bieringnil/bioamp-simple/bioamp-simple.kicad_pcb

## KiCad design bioamp-simple.kicad_pcb (2024-01-02)

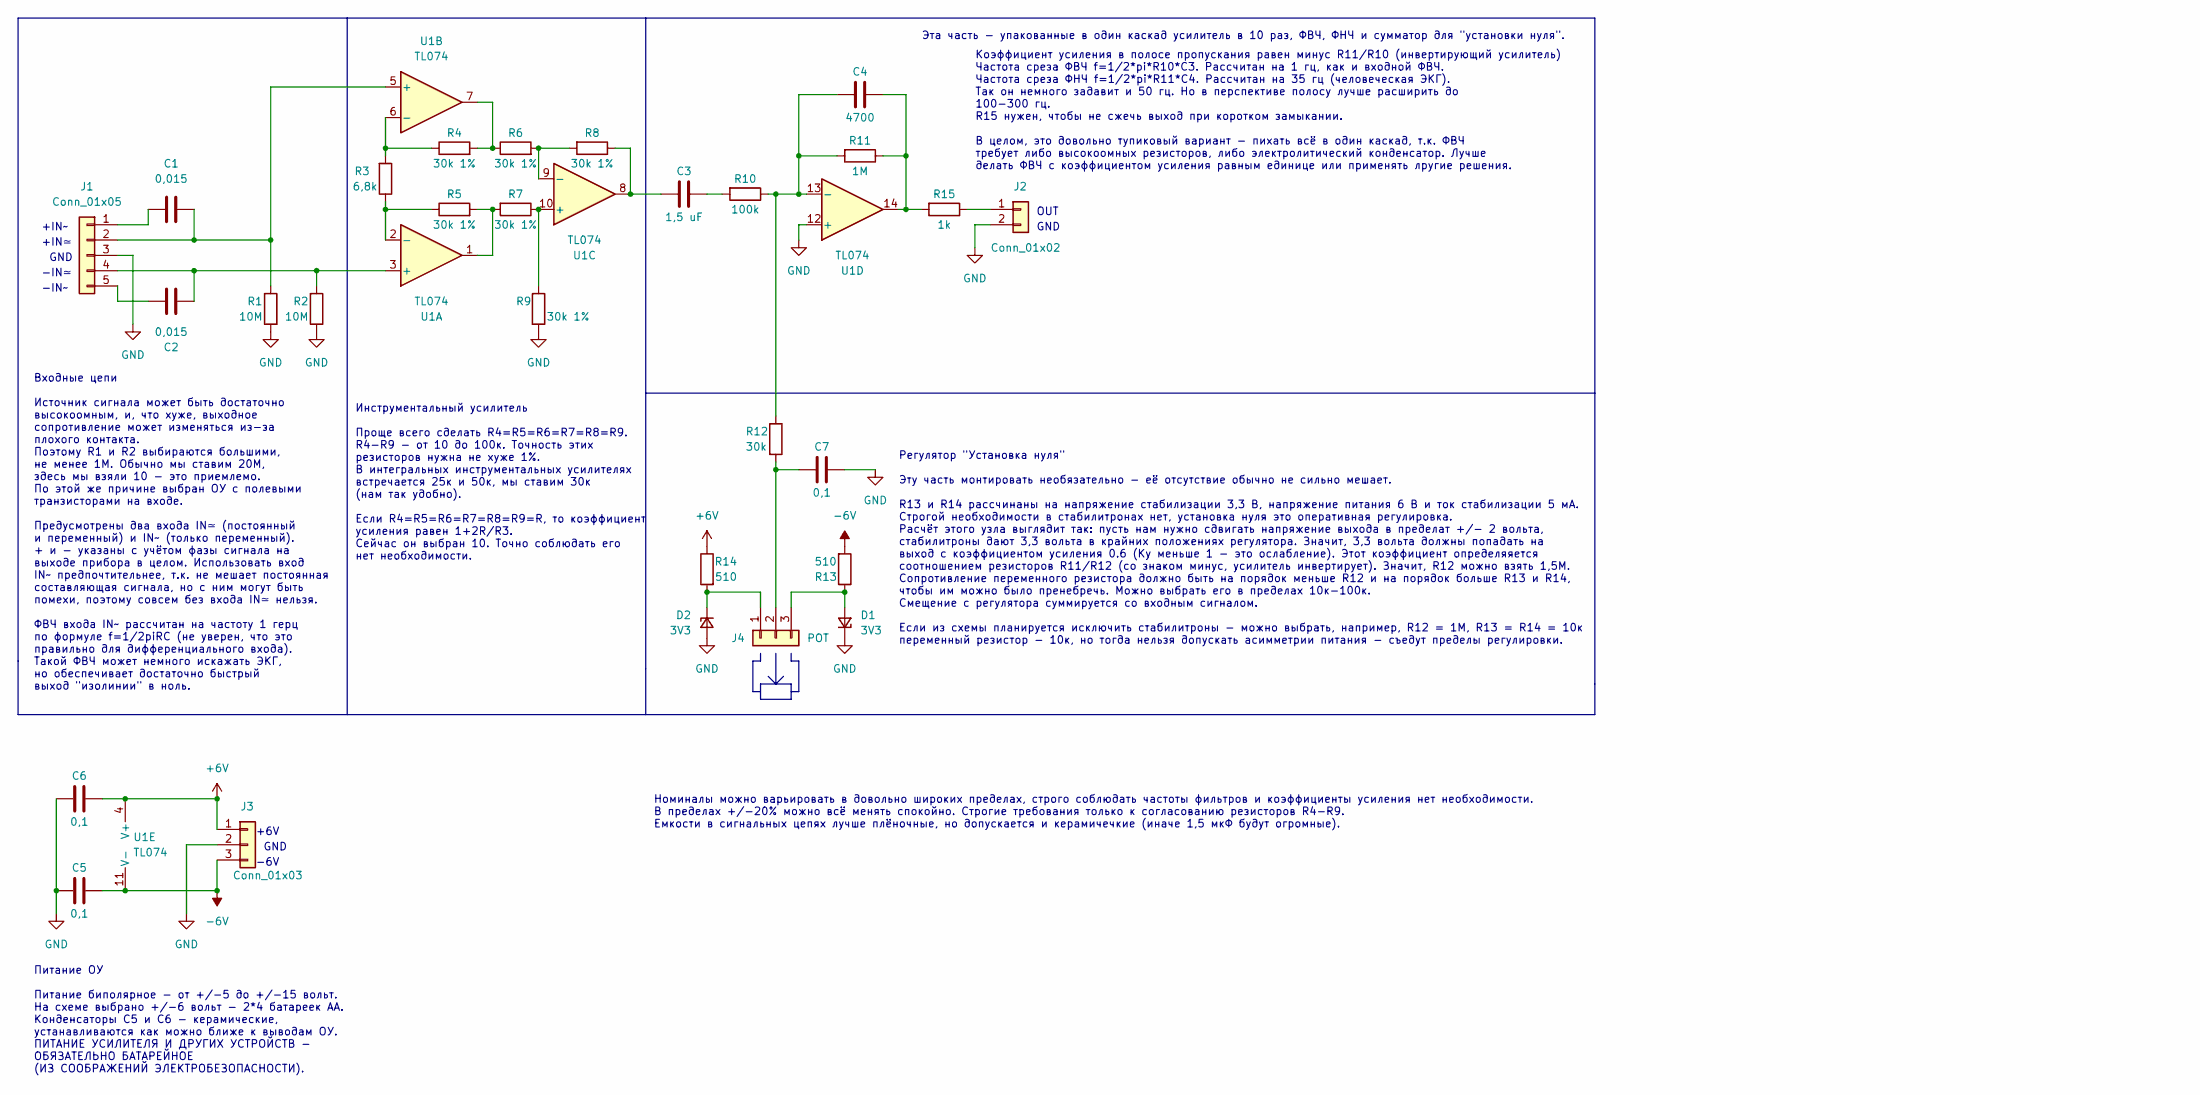
[picture p1: schematic bioamp-simple.kicad_sch]

Parts:
C1, C2: 0,015; C_Rect_L7.0mm_W4.5mm_P5.00mm
C3: 1,5 uF; C_Rect_L16.5mm_W5.0mm_P15.00mm_MKT
C4: 4700; C_Rect_L7.0mm_W4.5mm_P5.00mm
C5, C6, C7: 0,1; C_Rect_L7.0mm_W4.5mm_P5.00mm
D1, D2: 3V3; D_A-405_P10.16mm_Horizontal
J1: Conn_01x05; SolderWire-0.5sqmm_1x05_P4.6mm_D0.9mm_OD2.1mm
J2: Conn_01x02; SolderWire-0.5sqmm_1x02_P4.6mm_D0.9mm_OD2.1mm
J3: Conn_01x03; SolderWire-0.5sqmm_1x03_P4.6mm_D0.9mm_OD2.1mm
J4: POT; SolderWire-0.5sqmm_1x03_P4.6mm_D0.9mm_OD2.1mm
R1, R2: 10M; R_Axial_DIN0207_L6.3mm_D2.5mm_P15.24mm_Horizontal
R3: 6,8k; R_Axial_DIN0207_L6.3mm_D2.5mm_P10.16mm_Horizontal
R4, R5, R8: 30k 1%; R_Axial_DIN0207_L6.3mm_D2.5mm_P2.54mm_Vertical
R6, R7, R9: 30k 1%; R_Axial_DIN0207_L6.3mm_D2.5mm_P10.16mm_Horizontal
R10: 100k; R_Axial_DIN0207_L6.3mm_D2.5mm_P10.16mm_Horizontal
R11: 1M; R_Axial_DIN0207_L6.3mm_D2.5mm_P2.54mm_Vertical
R12: 30k; R_Axial_DIN0207_L6.3mm_D2.5mm_P10.16mm_Horizontal
R13, R14: 510; R_Axial_DIN0207_L6.3mm_D2.5mm_P10.16mm_Horizontal
R15: 1k; R_Axial_DIN0207_L6.3mm_D2.5mm_P10.16mm_Horizontal
U1: TL074; DIP-14_W7.62mm_LongPads

Connections:
+6V: C6.2, J3.1, R14.1, U1.4 (V+)
-6V: C5.2, J3.3, R13.2, U1.11 (V-)
GND: C5.1, C6.1, C7.2, D1.1 (K), D2.2 (A), J1.3, J2.2, J3.2, R1.2, R2.1, R9.2, U1.12 (+)
unnamed: C3.1, R8.1, U1.8
unnamed: C3.2, R10.2
unnamed: C4.2, R11.1, R15.2, U1.14
unnamed: D1.2 (A), J4.3, R13.1
unnamed: D2.1 (K), J4.1, R14.2
unnamed: C1.1, J1.1
unnamed: C1.2, J1.2, R1.1, U1.5 (+)
unnamed: C2.2, J1.4, R2.2, U1.3 (+)
unnamed: C2.1, J1.5
unnamed: J2.1, R15.1
unnamed: C7.1, J4.2, R12.2
unnamed: R4.2, R6.1, U1.7
unnamed: R5.2, R7.2, U1.1
unnamed: R3.1, R5.1, U1.2 (-)
unnamed: R3.2, R4.1, U1.6 (-)
unnamed: R7.1, R9.1, U1.10 (+)
unnamed: R6.2, R8.2, U1.9 (-)
unnamed: C4.1, R10.1, R11.2, R12.1, U1.13 (-)

Notes on the sheet:
+IN~
Входные цепи Источник сигнала может быть достаточно высокоомным, и, что хуже, выходное сопротивление может изменяться из-за плохого контакта. Поэтому R1 и R2 выбираются большими, не менее 1М. Обычно мы ставим 20М, здесь мы взяли 10 - это приемлемо. По этой же причине выбран ОУ с полевыми транзистор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
+6V
OUT
Питание ОУ Питание биполярное - от +/-5 до +/-15 вольт. На схеме выбрано +/-6 вольт - 2*4 батареек АА. Конденсаторы C5 и C6 - керамические, устанавливаются как можно ближе к выводам ОУ. ПИТАНИЕ УСИЛИТЕЛЯ И ДРУГИХ УСТРОЙСТВ - ОБЯЗАТЕЛЬНО БАТАРЕЙНОЕ (ИЗ СООБРАЖЕНИЙ ЭЛЕКТРОБЕЗОПАСНОСТИ).
-IN≃
Инструментальный усилитель Проще всего сделать R4=R5=R6=R7=R8=R9. R4-R9 - от 10 до 100к. Точность этих резисторов нужна не хуже 1%. В интегральных инструментальных усилителях встречается 25к и 50к, мы ставим 30к (нам так удобно). Если R4=R5=R6=R7=R8=R9=R, то коэффициент усиления равен 1+2R/R3. Сейч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
Эта часть - упакованные в один каскад усилитель в 10 раз, ФВЧ, ФНЧ и сумматор для "установки нуля".
GND
Регулятор "Установка нуля" Эту часть монтировать необязательно - её отсутствие обычно не сильно мешает. R13 и R14 рассчинаны на напряжение стабилизации 3,3 В, напряжение питания 6 В и ток стабилизации 5 мА. Строгой необходимости в стабилитронах нет, установка нуля это оперативная регулировка. Расчё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
-6V
Коэффициент усиления в полосе пропускания равен минус R11/R10 (инвертирующий усилитель) Частота среза ФВЧ f=1/2*pi*R10*C3. Рассчитан на 1 гц, как и входной ФВЧ. Частота среза ФНЧ f=1/2*pi*R11*C4. Рассчитан на 35 гц (человеческая ЭКГ). Так он немного задавит и 50 гц. Но в перспективе полосу лучше ра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
Номиналы можно варьировать в довольно широких пределах, строго соблюдать частоты фильтров и коэффициенты усиления нет необходимости. В пределах +/-20% можно всё менять спокойно. Строгие требования только к согласованию резисторов R4-R9. Емкости в сигнальных цепях лучше плёночные, но допускается и к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
+IN≃
-IN~

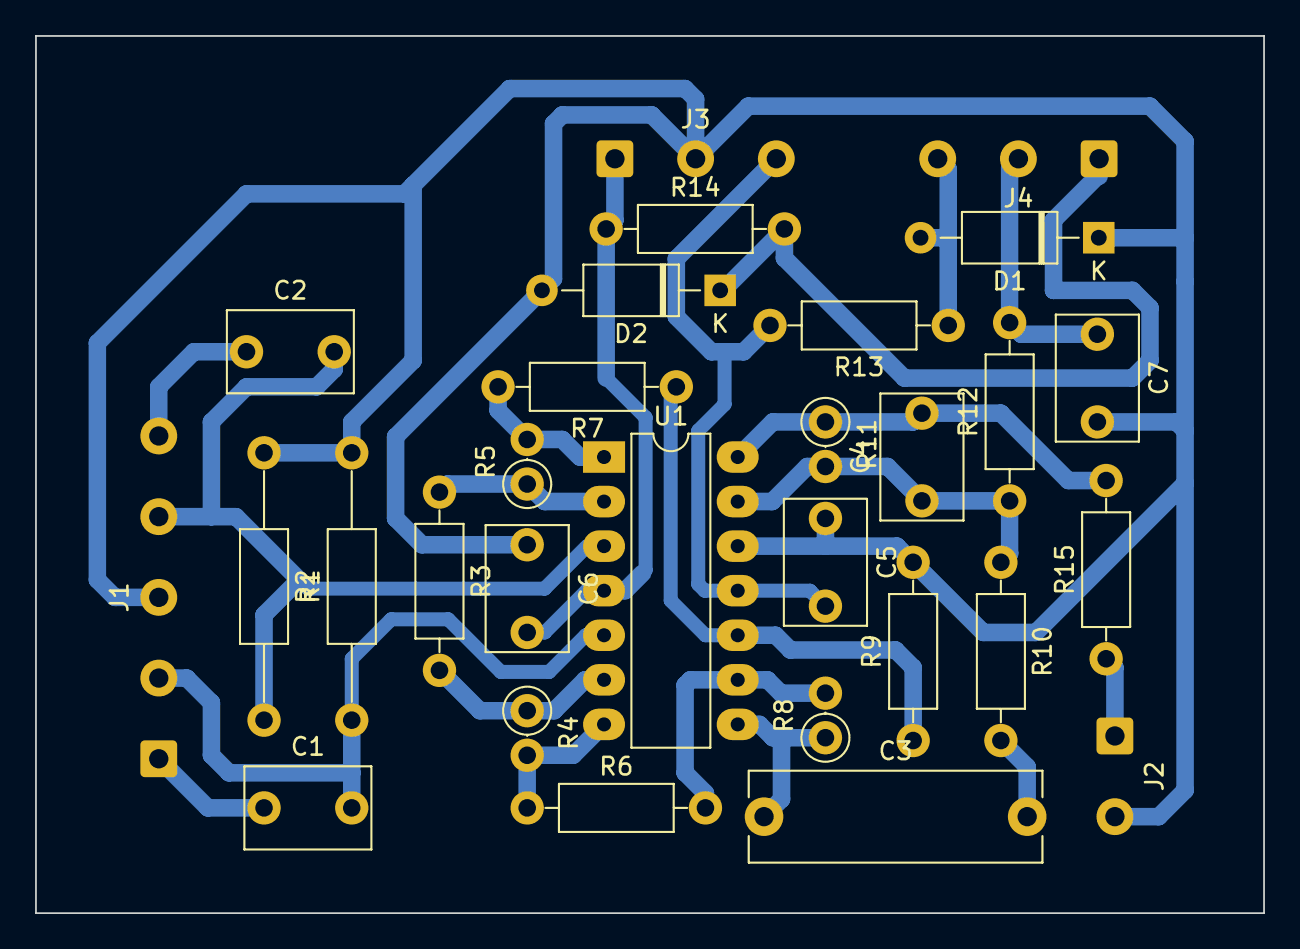
[picture p2: board bioamp-simple.kicad_pcb from above]

Board: 2 copper layers, 70.0 x 50.0 mm, 29 parts (0 on the bottom side), 21 nets.
